shree-surya/GridGuard/(commit log)

2026-10-15 Start GridGuard: display test with simulated readings, spec, tools
    firmware/GridGuard_display_test runs the five planned screens on the
    1.77in ST7735S TFT with made-up readings and the real trip state machine.
    Text is Bai Jamjuree, converted to Adafruit GFX fonts by tools/ttf2gfx.py.
    The spec and project page come from the PowerScope repo history, with the
    pins updated for the TFT (touch pad moved to GPIO13) and the power notes
    from the PowerScope bench build.
    Claude-Session: https://claude.ai/code/session_018QBtkVoQuqfaWWn4kFVBk7
2026-10-15 Add complete wiring guide
    Pin map, low-voltage diagram, each module, power (Hi-Link straight to
    VIN, 470 uF), mains path with the relay on NO, and the pre-power checks.
    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
2026-10-15 Replace the touch pad with a push button on GPIO13
    Button to GND with the internal pull-up, no resistor; same short-press and
    2 s hold actions.
    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
2026-10-15 Add a hardware test sketch for the full wiring
    One screen showing both sensor midpoints (OK near 1650 mV) and rough volts
    and amps, the relay state, and the button. Each button press toggles the
    relay and beeps. Relay starts off. Single file, default font.
    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
2026-10-15 Add GridGuard firmware 0.1.0: protection, display, button, buzzer
    Measures V and I every 200 ms (PowerScope method), trips the relay after
    the trip delay on over/under-voltage or over-current (under-current
    optional), reconnects after the restart delay once the voltage is back in
    band, and holds the relay open for the restart delay at power-up. Button:
    short press next screen, the screen otherwise stays; hold 2 s resets a
    trip, refused while the supply is out of range. A trip beeps and brings
    Home up. Calibration over Serial (V, I, Z, F, D) saved in flash. Checked
    in a PC simulation with the real Adafruit GFX library; not yet on hardware.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
2026-10-22 Move the TFT SPI data line to GPIO19, pins set at the top of each sketch
    TFT_SDA (MOSI) and TFT_SCK are now constants (19 and 18) and the sketches
    start hardware SPI on them with SPI.begin(SCK, -1, SDA, CS) before the
    display init, so the wiring as built (SDA on GPIO19) works without
    resoldering. Docs updated; GPIO23 is free again.
    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
2026-10-22 Firmware 0.2.0: WiFi web page with live data, OVV/UVV/OCV/OPP limits and relay ON/OFF
    - Own hotspot GridGuard (192.168.4.1) with captive-portal answers, page gzipped into web_index.h
    - /data, /history, /trips, POST /limits (validated, applied in loop, saved in flash), POST /relay
    - New over-power (OPP) trip; manual OFF state; button hold toggles the relay
    - New GridGuard palette (amber, periwinkle, rose, mint) on the TFT and the page, Bai Jamjuree embedded
    - Connect screen replaces Info; README and wiring notes updated
    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
2026-10-22 Firmware 0.3.0: calibration on the web page and relay override when the supply is out of range
    - Calibration section: match a multimeter / clamp meter, type gain, voltage offset, current trim
    and zero offset, measure zero (non-blocking, 20 windows), flip direction, defaults; all saved in flash
    - New voltage offset (flash key voff), also Serial O <volts>
    - Relay ON by hand (web or button hold) now works with the supply out of range: voltage limits
    are paused until it is back in range, over-current and over-power stay active; OVERRIDE shown
    on the TFT and the page
    Claude-Session: https://claude.ai/code/session_018QBtkVoQuqfaWWn4kFV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
2026-10-24 Drive active-low relay modules: 0 V for ON, pin released for OFF
    Most 5 V relay modules without an H/L jumper switch on when IN is pulled to 0 V and stay off with IN
    unconnected. RELAY_ACTIVE_LOW (default true) pulls GPIO26 low for ON and makes it an input for OFF,
    so the relay also stays off while the ESP32 boots. No pull-down resistor on GPIO26 for these modules.
    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
2026-10-24 Spec: relay row matches the active-low drive
    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
2026-10-24 Relay: red LED in series with IN for active-low modules (tested on the bench)
    A released ESP32 pin only reaches about 3.6 V, which still switches a 5 V active-low module on.
    The LED drops about 1.8 V so OFF really is off, and lights while the relay is on.
    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
2026-10-24 Firmware 0.4.0: LSL/USL windows for voltage, current and power; 5 s button reset with countdown
    - Limits table on the web page: lower and upper limit for each of V, I, P, any values (LSL < USL);
    under-current and under-power checked from 5 s after the relay closes; LSL 0 never trips
    - Voltage trips restart by themselves once back in range; current and power trips lock the relay
    off until reset (web ON or button hold 5 s)
    - Button: relay off -> hold 5 s, TFT shows RESETTING 5 4 3 2 1 (let go to cancel), then the relay
    closes and every limit is checked again; relay on -> hold 2 s turns it off
    - Limits saved as lim2; limits from 0.2 / 0.3 are migrated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
2026-10-24 Add project documentation (Word and PDF) with block, wiring, mains and state diagrams
    Build guide, standard operating procedure and project report for firmware 0.4.0: specifications,
    how it works (limits, states, relay drive), components list, pin map, low-voltage and mains wiring,
    safety, assembly, checks, daily use, limits and resets, flashing, calibration and protection tests,
    TFT and web page guide, troubleshooting, web API. Diagram PNGs in docs/diagrams.
    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
2026-10-27 Documentation: student project report version
    Cover with blank team / college / guide fields and a short mains warning; no contents, scope,
    tools, SOP, limitations or appendices; buzzer and status LEDs removed from text, tables and
    diagrams; red series LED described as the relay-on indicator; short limits and reset guide in
    section 3; components without quantity and price; firmware from the provided zip.
    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
